petrbrouzda/MluviciZvire/doc/montaz1.jpg

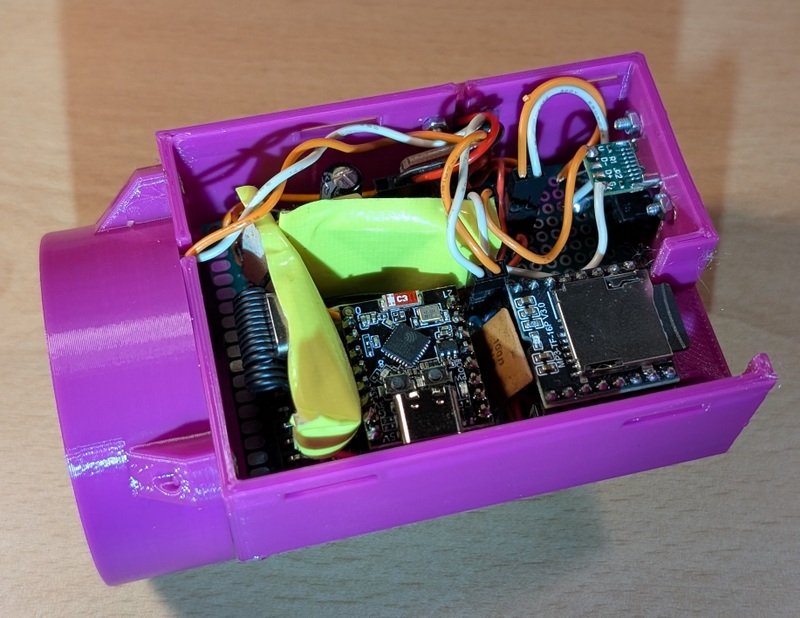
doc/montaz1.jpg
