petrbrouzda/MluviciZvire/doc/montaz3.jpg

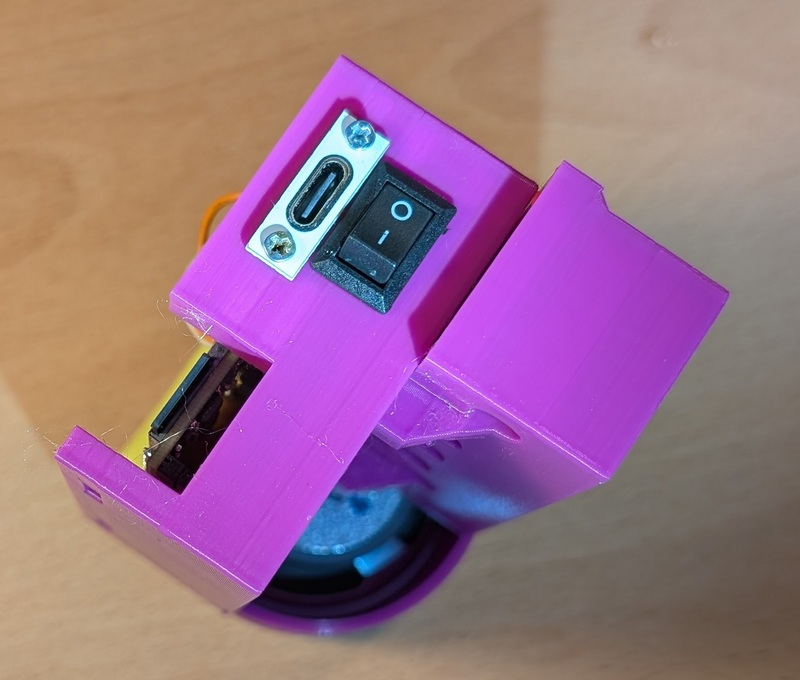
doc/montaz3.jpg
